jerusalem-science-museum/ftc-cartesian-polar-plotters/doc/pic/20260330_191511.jpg

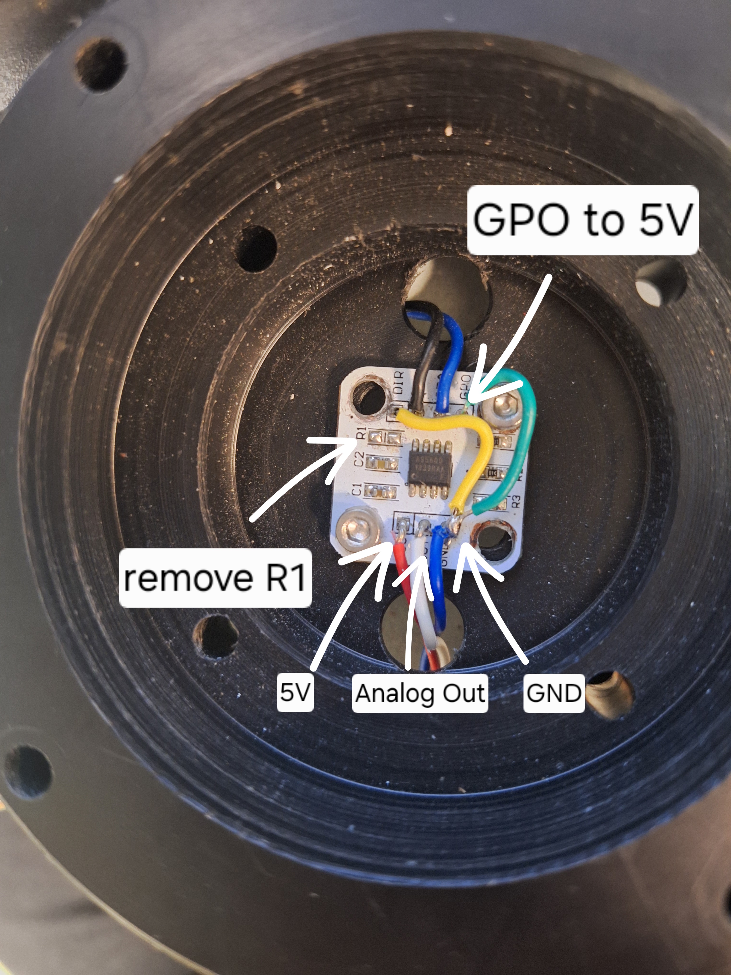
doc/pic/20260330_191511.jpg
