jerusalem-science-museum/ftc-cartesian-polar-plotters/doc/pic/20260330_191524.jpg

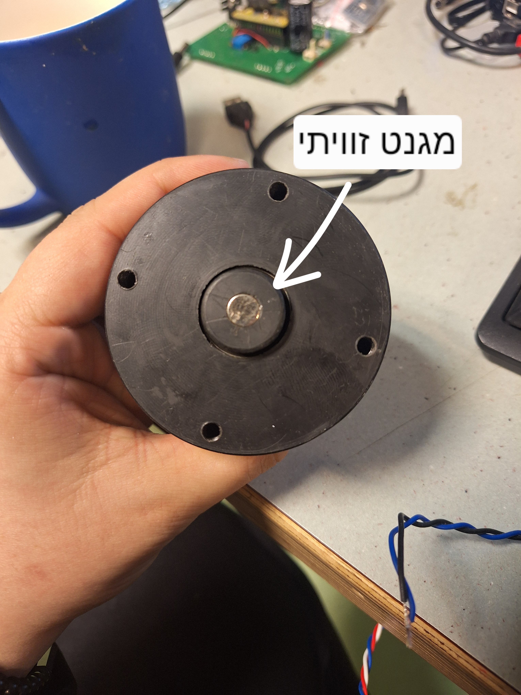
doc/pic/20260330_191524.jpg
