jerusalem-science-museum/ftc-cartesian-polar-plotters/סיכום_חיישן_AS5600.docx

סיכום חיישן מגנטי 5600

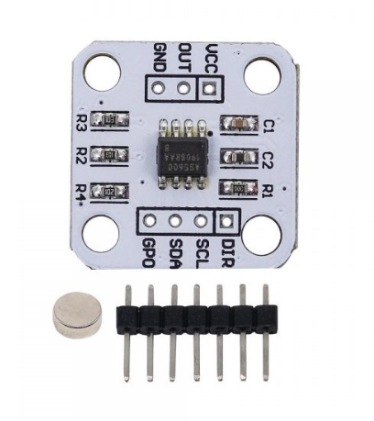
[picture p3: figure]

30/03/2026

בגלל שה-encoder המכני נהרס החלפנו אותו בעזרת רכיב AS5600 שמזהה את השינוי בשדה המגנטי לפי זווית.(ראה איור 1).

ומגנט זוויתי ליצירת שדה מגנטי מסתובב.(ראה איור 2).

חייבים להוציא את נגד R1 כדי לעבוד ב-5V ולהוציא את נגד R4 או לחבר את GPO ל-5V כדי שרגל Analog OUT לא ישאר תקוע על 5V.

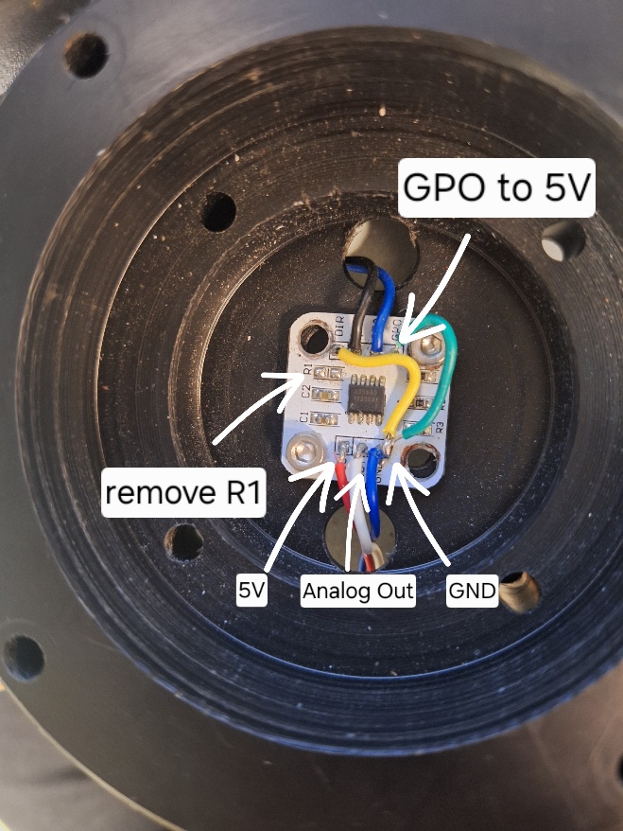
[picture p4: figure]
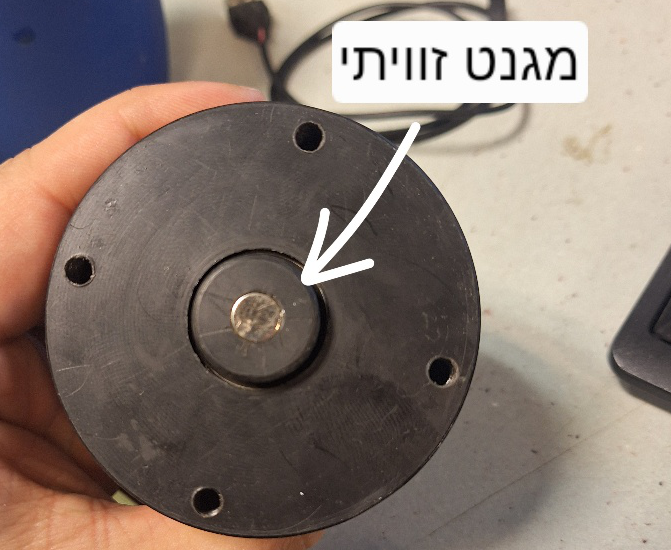
[picture p5: figure]

איור 1

איור 2

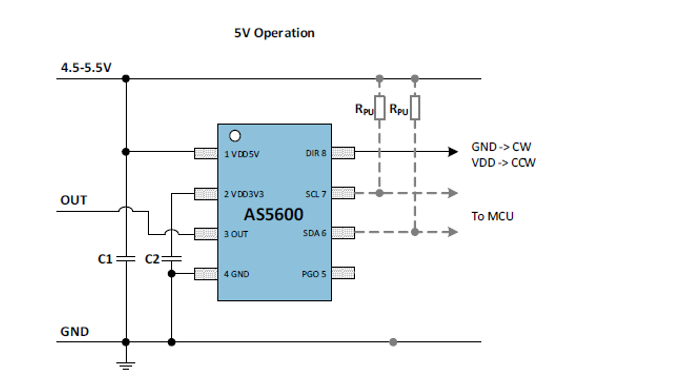
[picture p6: figure]

תרשים חשמלי עם כל השינויים

משימות פתוחות עד שהכרטיסים 5600AS יגיעו.

1. צריך להוציא את הנגד R1.
2. להוציא את נגד R4
3. לחבר מולקס זכר 3 פינים לכרטיס AS5600
4. צריך לצרוב את הקוד החדש בארדואינו (v2)
5. ולחבר את הכבלים ל-A6 ו- A7 למעגל המודפס של הארדואינו

09/04/2026

בוצעו משימות 1-4

13/04/2026

בוצע החלפת אנקודר לחיישן מגנטי בפולרי וקרטזי.

לשים לב כי יש שורה בקוד החדש (V2) שמגדירה את ההומינג אם זה עבור קרטזי או פולרי, שאר הקוד זהה.

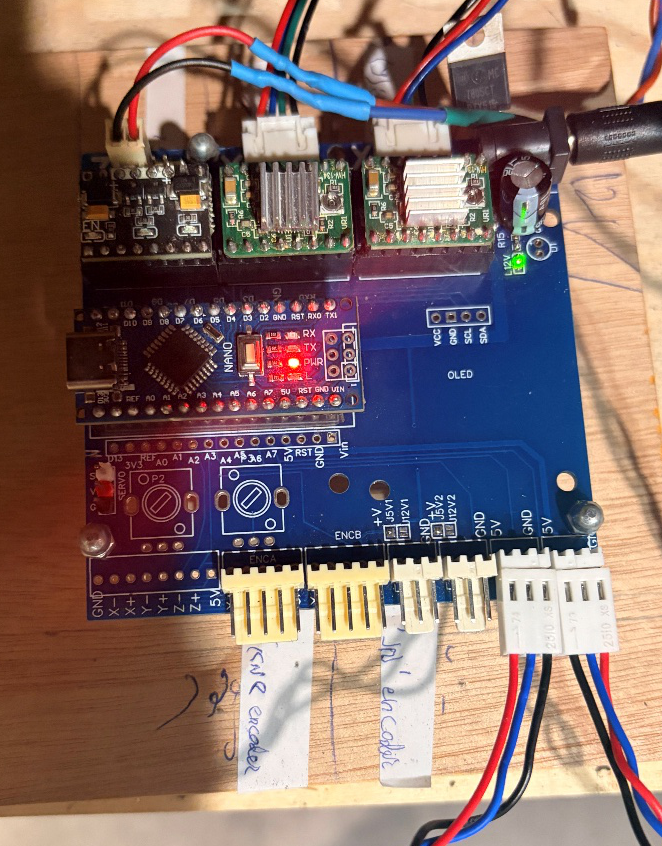
[picture p7: figure]
