jerusalem-science-museum/ftc-cartesian-polar-plotters/test/test_magnetic_sensor/burn_Zpos/סיכום.docx

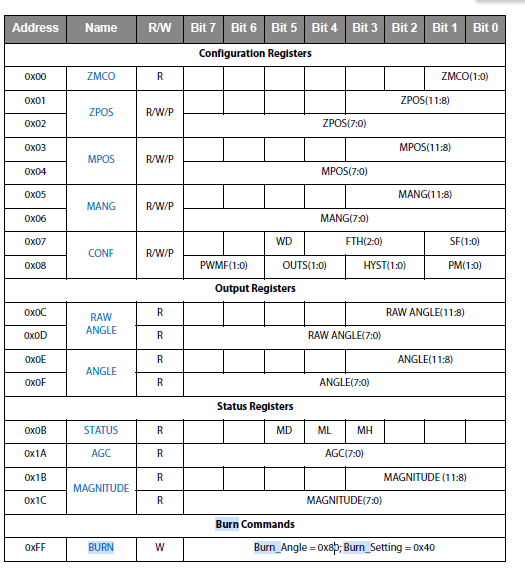
[picture p50: figure]
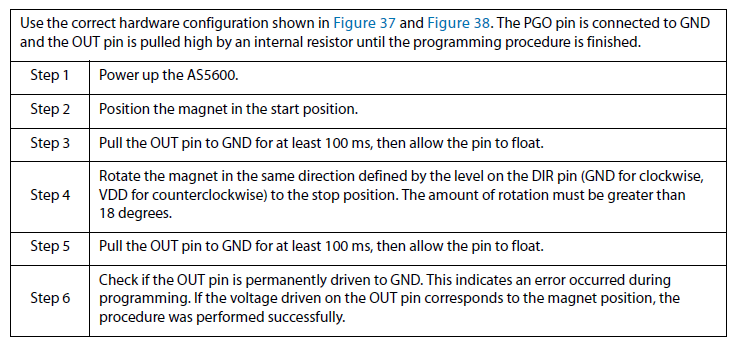
[picture p51: figure]
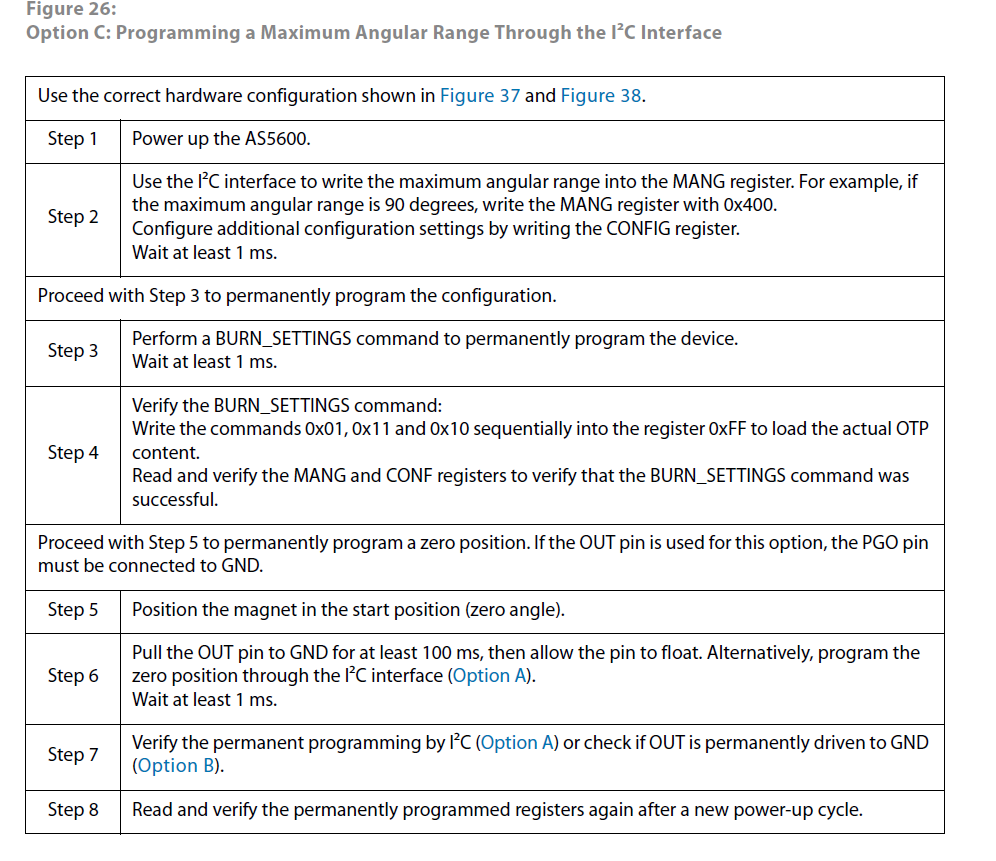
[picture p52: figure]
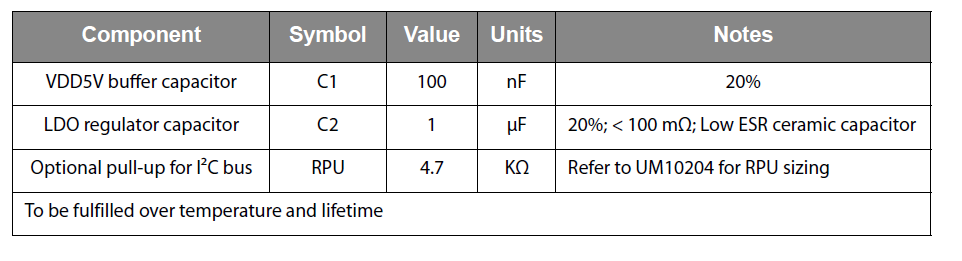
[picture p53: figure]

BURN ZPOS
