jerusalem-science-museum/ftc-cartesian-polar-plotters/encoder.pdf

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

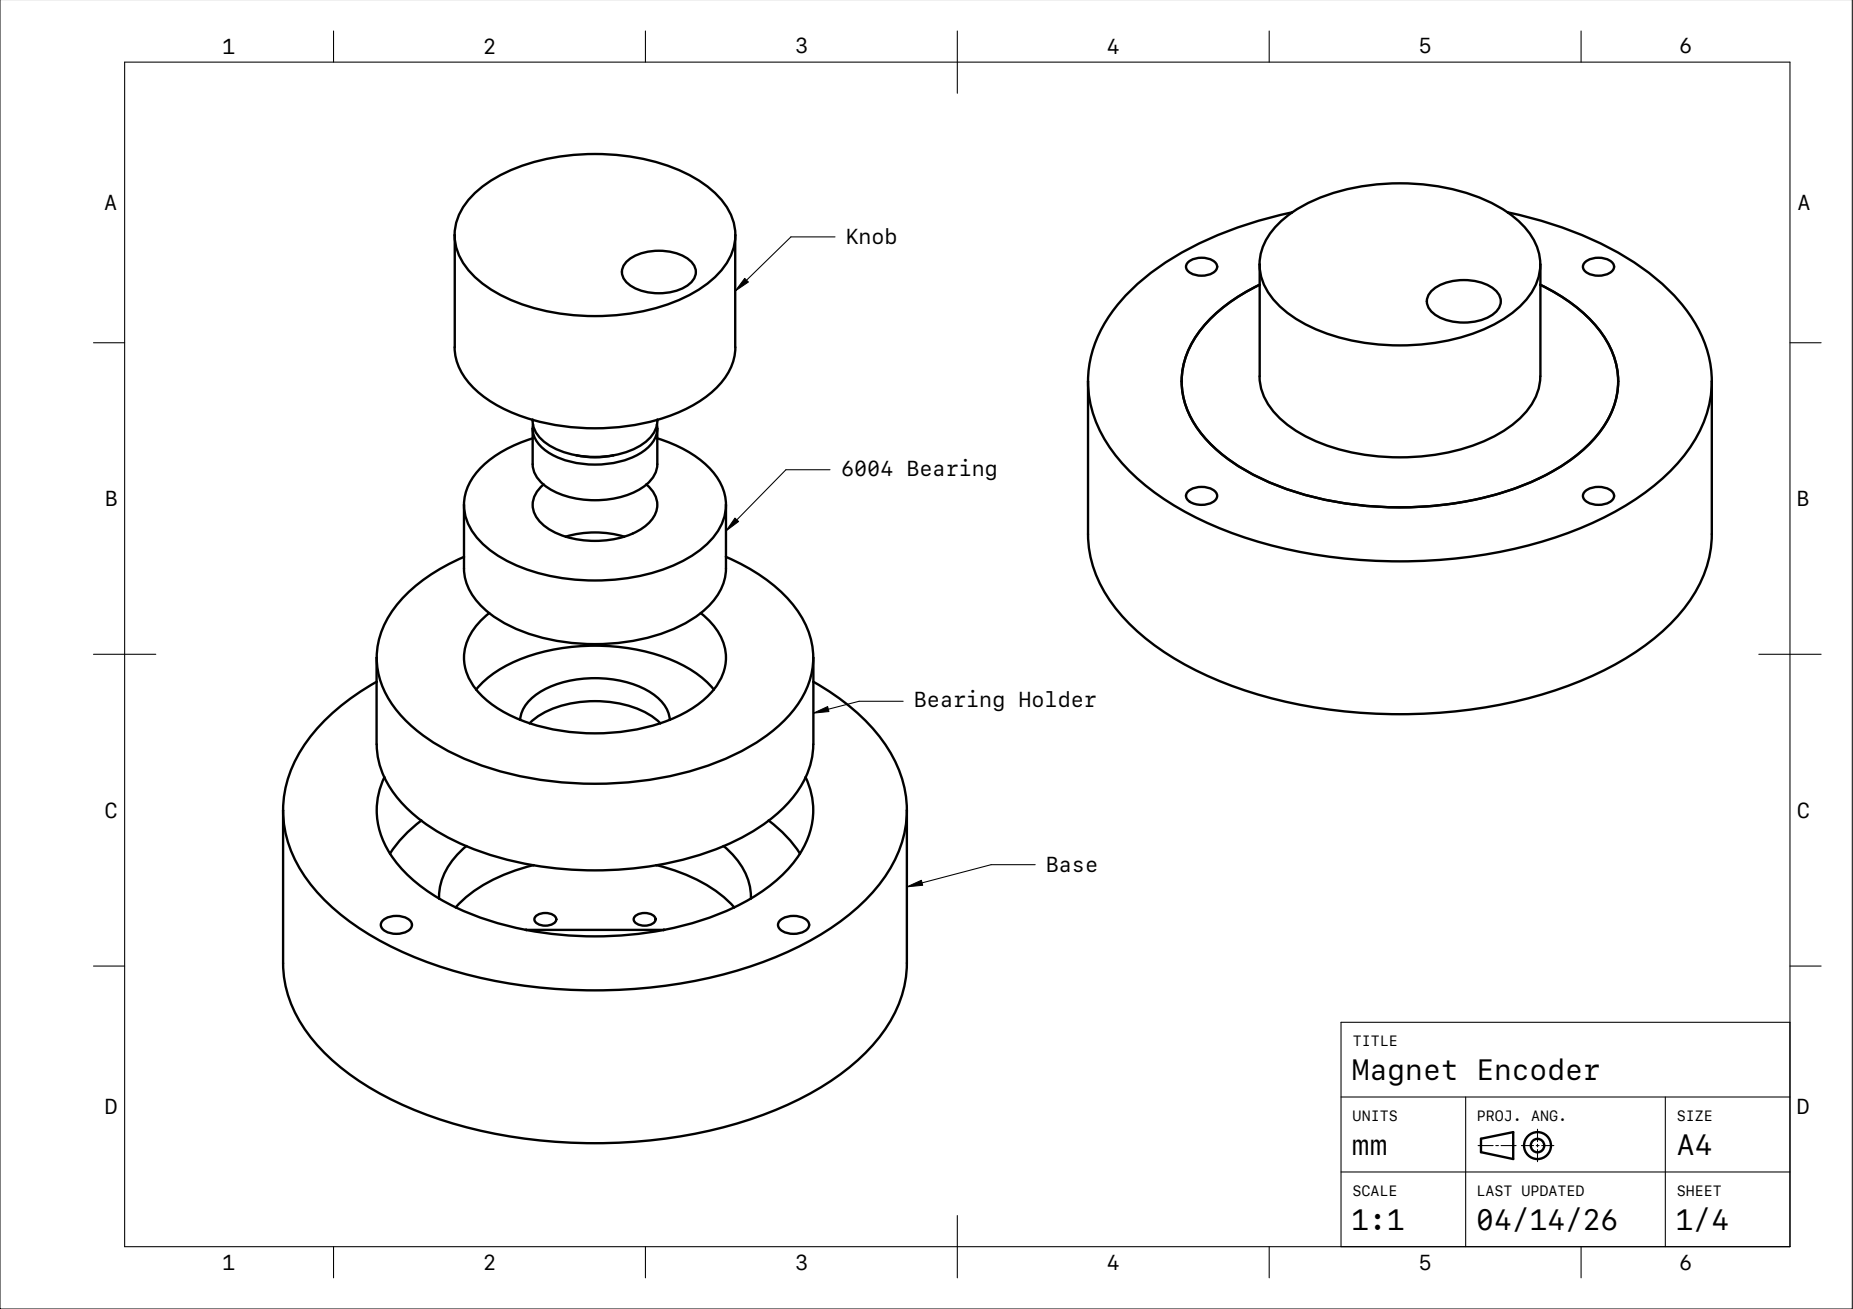
[picture p54: page 1]

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

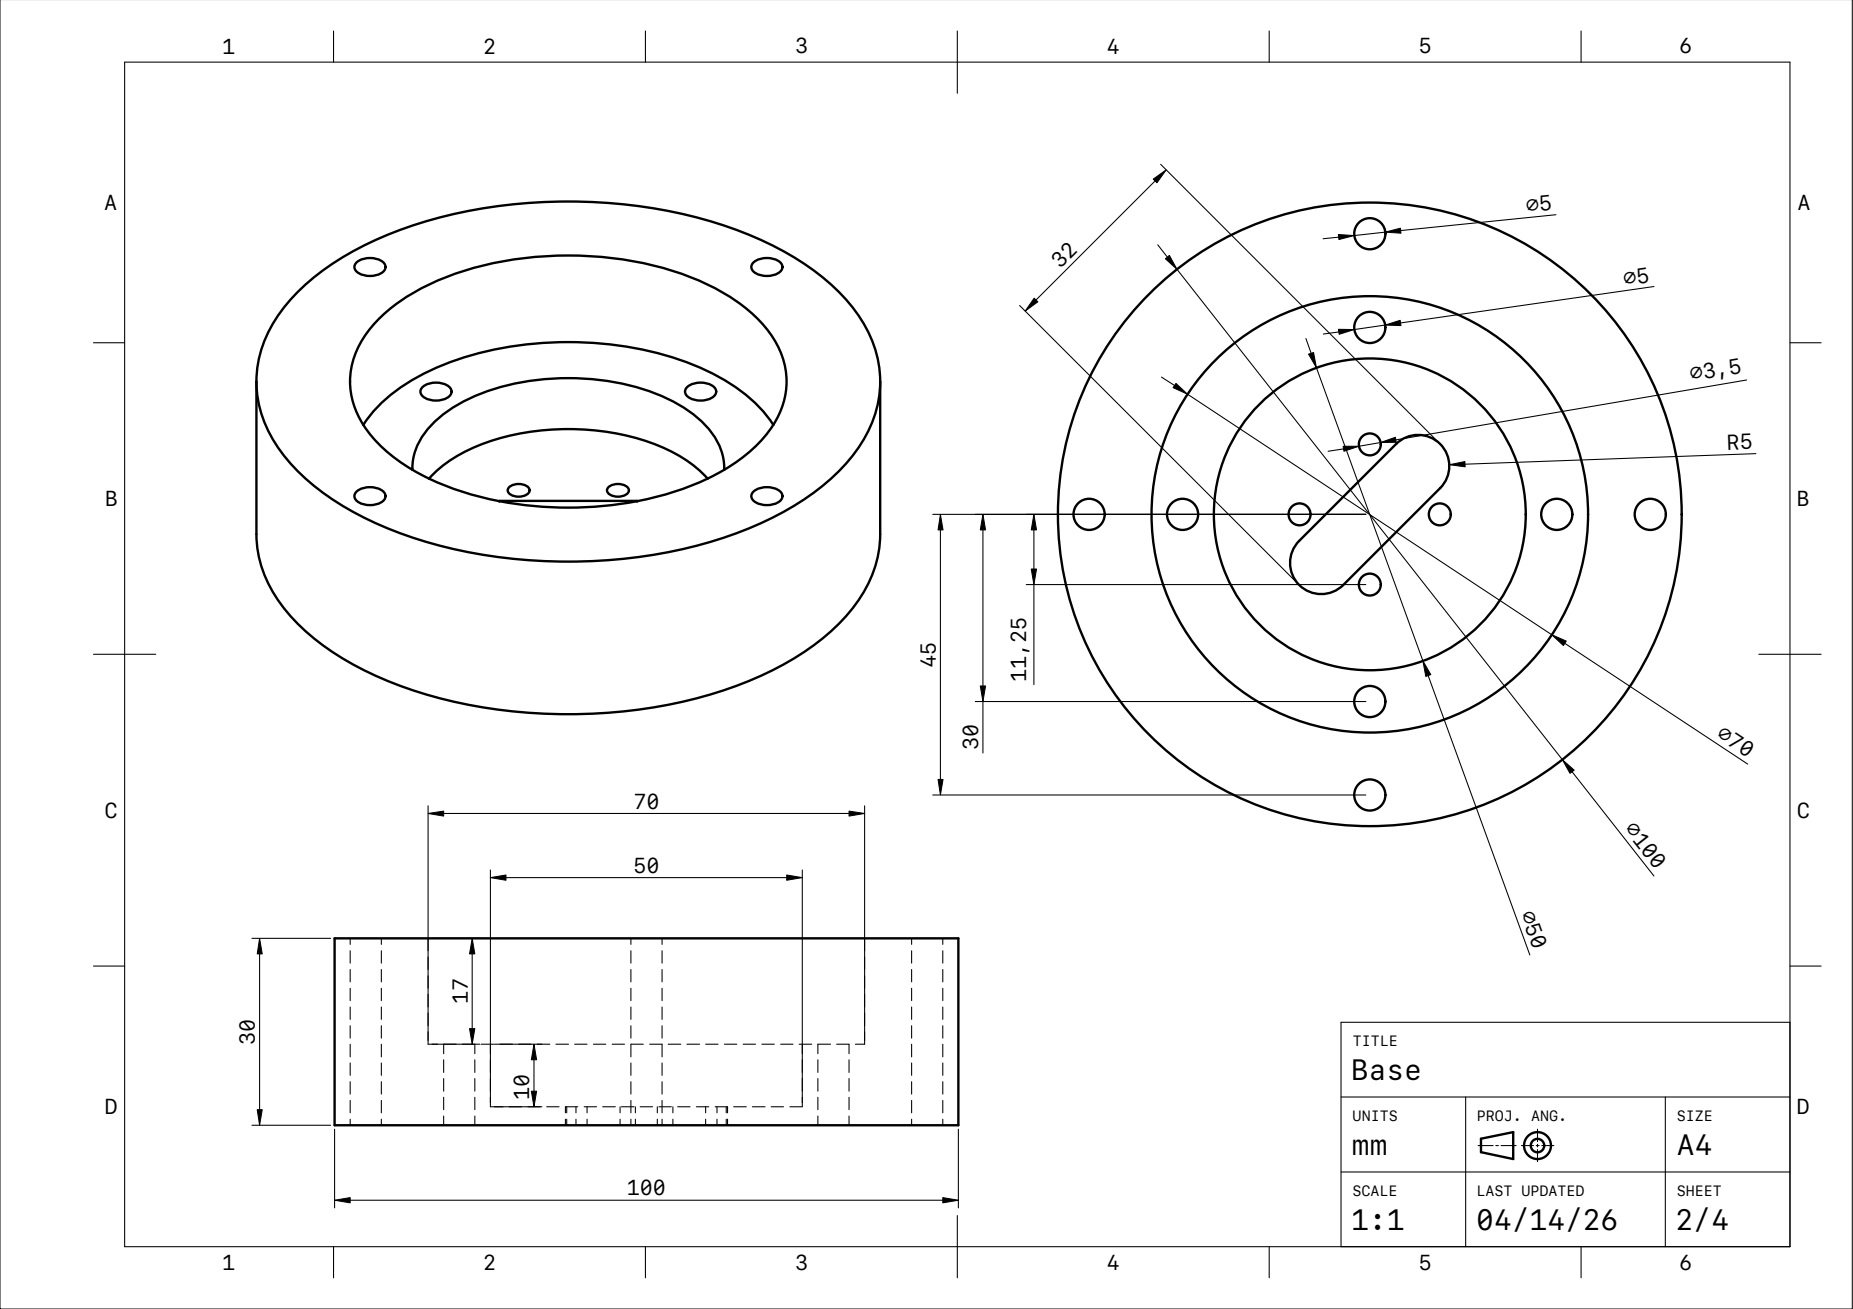
[picture p55: page 2]

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

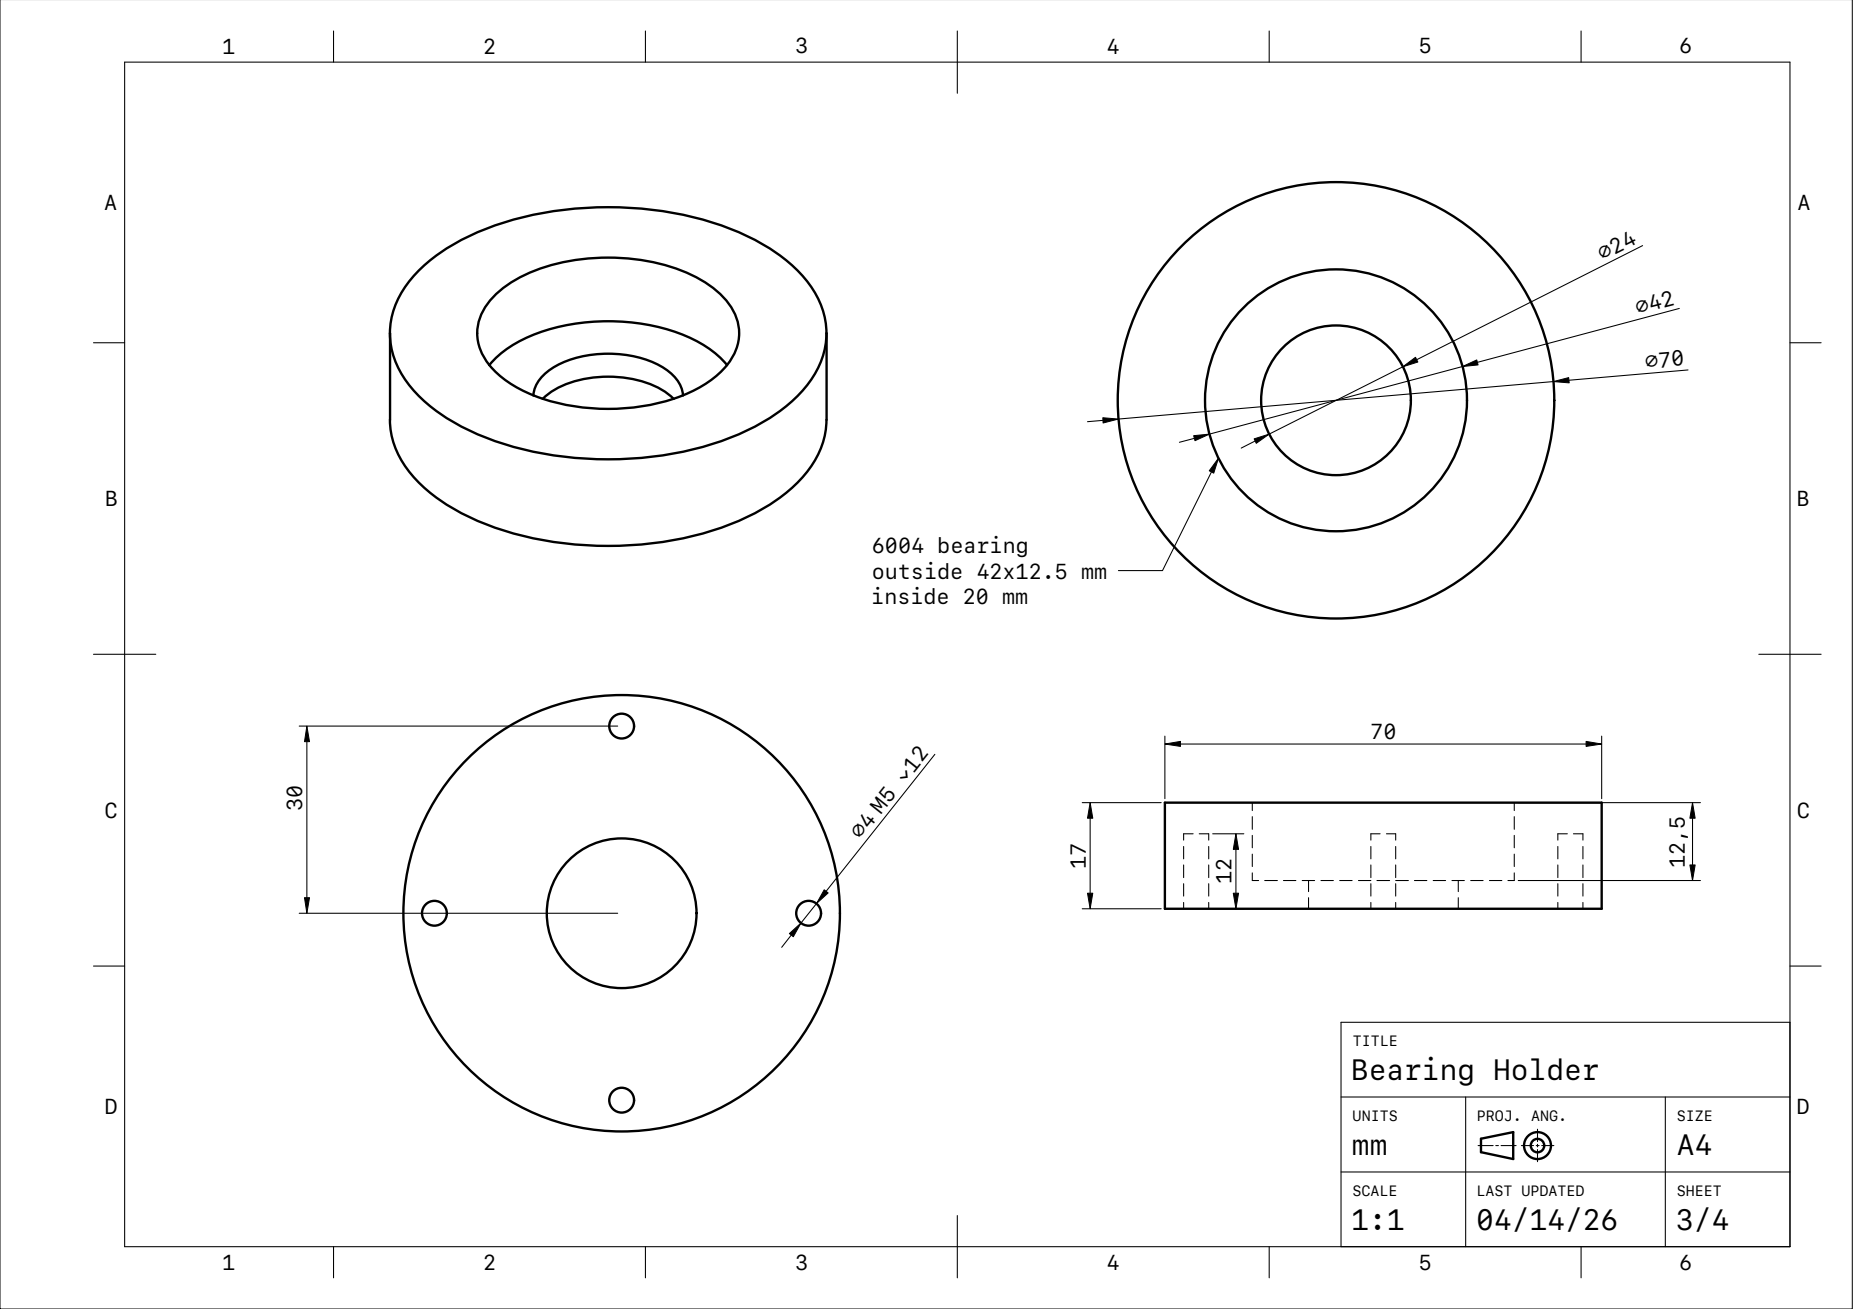
[picture p56: page 3]

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

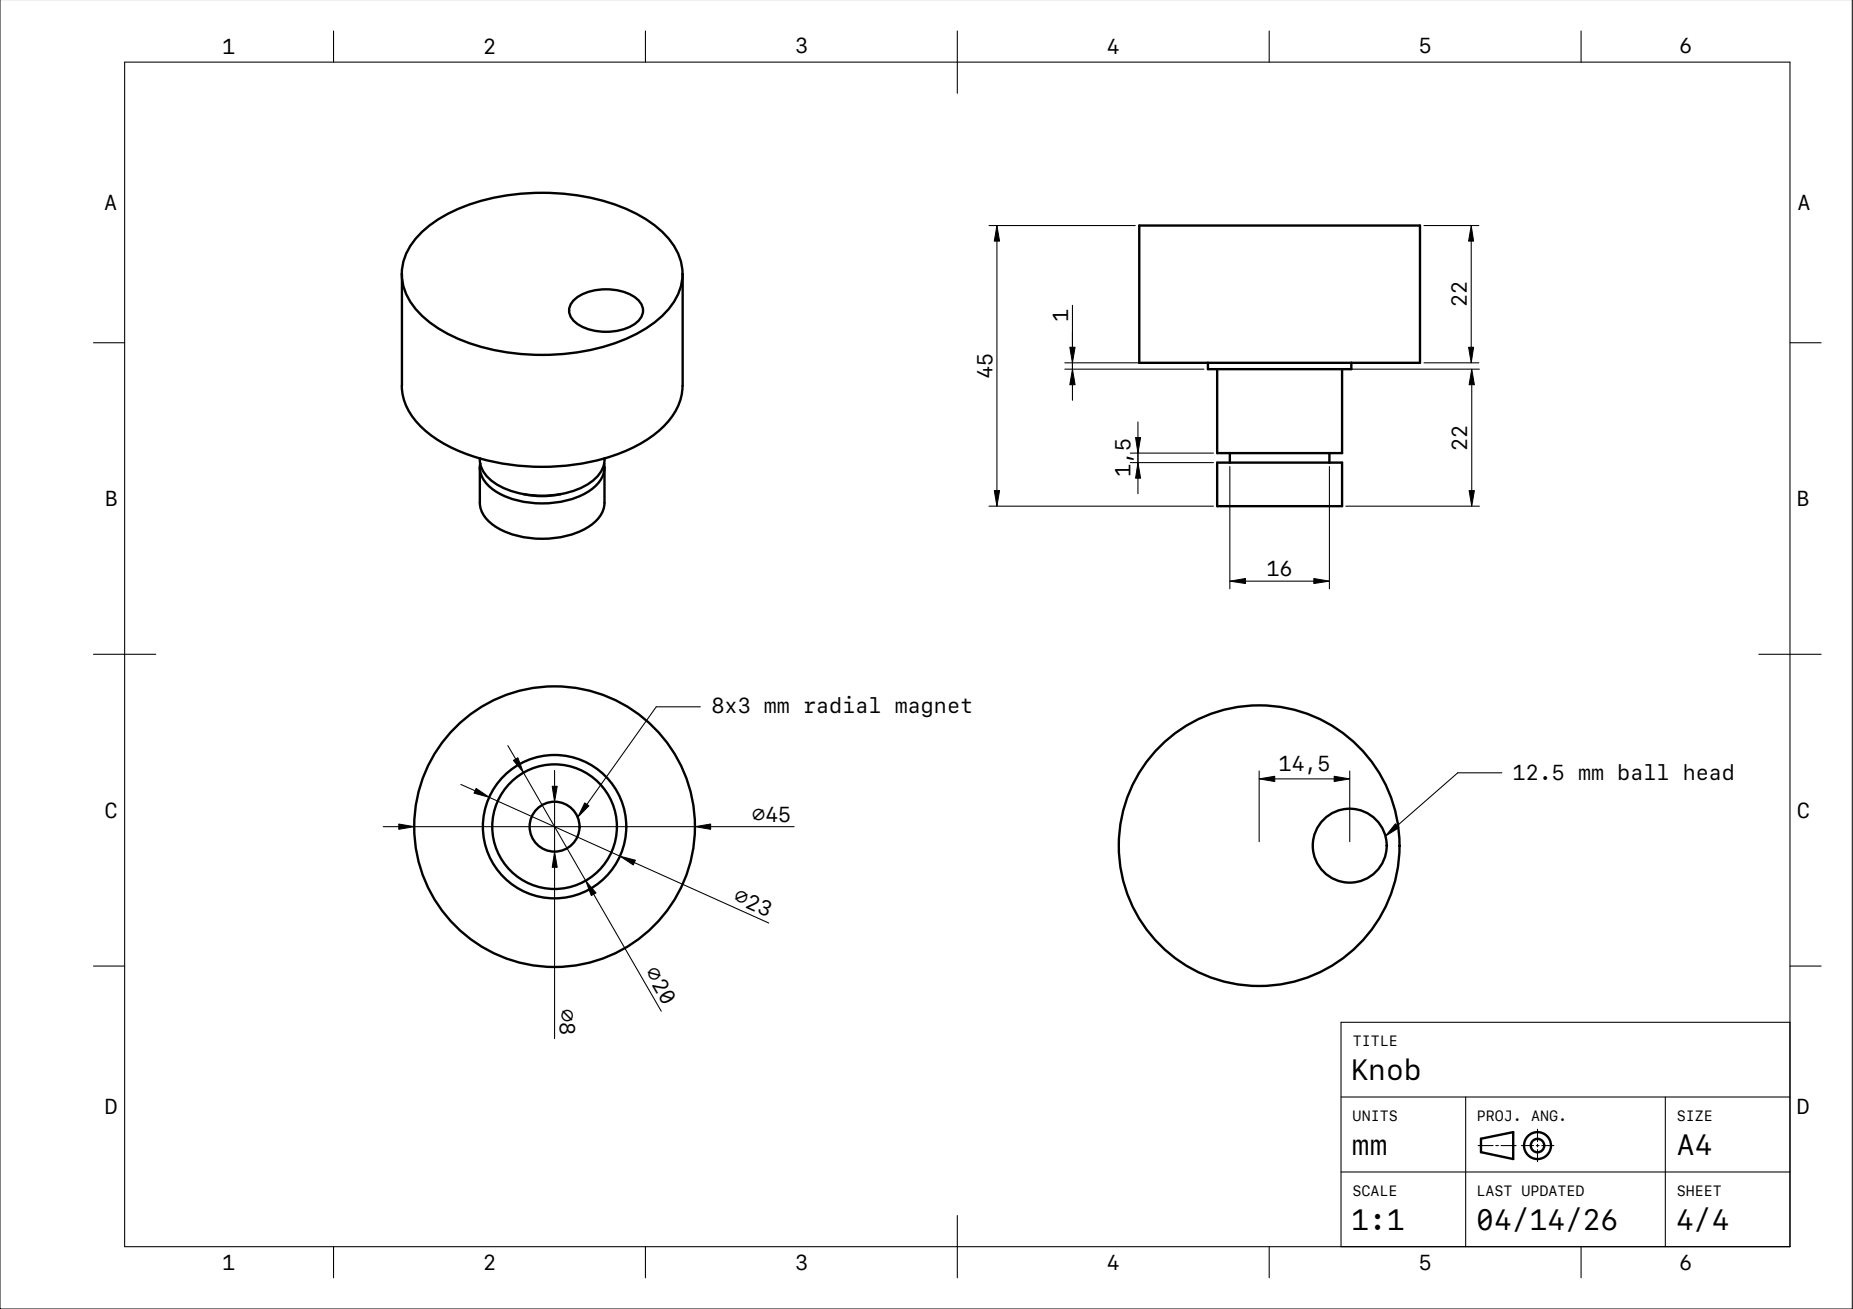
[picture p57: page 4]
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
