jerusalem-science-museum/ftc-cartesian-polar-plotters/(commit log)

2025-10-16 fix - location of maze homes for polar + xy also made small legal area for passing the finish line in polar.
    [CartesianMode.h, CartesianSettings.h, PlotterSystem.h, PolarMode.h, PolarSettings.h]
2026-02-24 updated docs and moved stepper run to mode responsability
2026-04-13 מעבר לחיישנים מגנטים
2026-04-14 הוספת קובץ עבור אנקודר מגנטי
2026-05-05 removed v1 v2, added MagneticEncoder.h and kept rotary.
